pythoncoderV/Bluetooth-Robotic-Arm/(9) TPU Modeling for Grip.md

2/1/25 - 2/12/25; (The last part of the project)

# TPU MODELING FOR TRACTION/GRIP:

I discovered that the three-finger gripper needed more traction to hold circular objects securely after completing the robotic arm structure. The entire bottom
of the arm was slick, so it wasn't just the gripper that lacked traction. On level surfaces, the servo case/enclosure and PVC circular base slid easily, needing
additional grip. I started by using extra rubber sheets I had lying around. The shapes were too asymmetrical and wouldn't fit correctly after being cut to fit the arm.
I was also unable to make the custom elastic support pieces I wanted out of the rubber sheet. TPU filament was the later solution as I would be able to design the custom
parts in CAD, and print them on my Ender 3 3D-printer easily. The printed parts would be very precise, so I started printing. The main challenge was adjusting my Ultimaker 
CURA slicer settings. I had been using normal PLA filament throughout the project, but now with TPU, I needed to change the settings. TPU required higher temperatures and 
better quality settings. After adjusting the TPU, I went to create the CAD models for the parts needed to print. The first parts to design were the TPU pieces for the 
bottom of the robotic arm to keep it in place. I designed two cylinders at a height of 1mm and cut each into halves to get 4 pieces for the PVC circular base. After 
placing them with hot glue, I designed pockets that would wrap around each of the 3 gripper fingers. After designing the pockets, I printed and press-fit them into each finger.

Here is the CAD model for the 2 bottom cylindrical pads (before being cut in halves): 



Here is the CAD model for 1 of the 3-finger gripper pockets: 





This is the final design of the TPU-printed gripper pocket:



These are all 3 of the TPU-printed gripper pockets placed on each of the gripper fingers:



This is a picture of 3 half-cylindrical pads placed on the bottom of the PVC circular base with hot-glue



This is where the 4th half-cylindrical pad was placed due to the edge of the enclosure for the robotic arm touching ground level:
(Refer to Board Management + Enclosure(SERVER).md)
