pythoncoderV/Bluetooth-Robotic-Arm/Custom Created CAD Models (By Me).md

These are the Custom CAD models I created myself for this project (These models are in TinkerCAD's browser website):

Base Construction CAD Model: https://www.tinkercad.com/things/egqu6U74zEA-360-turning-base
___________________________________________________________________________________________________________________________________
Shoulder Construction CAD Model: https://www.tinkercad.com/things/ffeTb6ennbH-arm-shoulder
Shoulder Construction CAD Model for 3D-printing: https://www.tinkercad.com/things/5AqSajbkO6N-arm-shoulder-fr-printing
___________________________________________________________________________________________________________________________________
3-Finger Gripper Construction CAD Model: https://www.tinkercad.com/things/5Qdoo5D9cre-3-finger-robotic-hand

SERVER/Arm Case/Enclosure for boards/parts CAD Model: https://www.tinkercad.com/things/jFY7OoK0D5L-case-fr-serverarm

___________________________________________________________________________________________________________________________________

Modified but taken from Thingiverse (I modified the top cover to add more space inside (Refer to Board Management + Enclosure(CLIENT).md)):

CLIENT/Joystick Remote Case/Enclosure for boards/parts CAD Model: https://www.tinkercad.com/things/i5cvhJYxiae-joystick-remote-caseclient

___________________________________________________________________________________________________________________________________

All TPU created models (3-finger gripper pockets + the 2 bottom cylindrical grip pads): 

https://www.tinkercad.com/things/7bJXujVLc1D-tpu-models-for-grip
