pythoncoderV/Bluetooth-Robotic-Arm/(6) KiCad Wiring Schematic(CLIENT).md

# WIRING(CLIENT):

This is the wiring schematic I used to wire all the components for the client/joystick wireless remote portion of the project. While creating this schematic, 
I realized there was no perfectly accurate KiCad symbol that fit the physical 5 pin 2-axis(x,y) Joystick module on SnapEDA, EasyEDA or anywhere else along the 
reach of the Internet. I then tried to create my own accurate Joystick Symbol for the schematic through the symbol creator/editor accessory:

 

After finishing the symbol, I uploaded it into the full schematic to have complete wiring for the Joystick Remote/client:
(For the ESP32 shown in the schematic, it's using the wrong board but the pins are the exact same as the ESP-WROOM-32 I used for the
project)
