pythoncoderV/Bluetooth-Robotic-Arm/(3) Wrist Joint Construction.md

11/1/25; (The third part of the project)

# WRIST JOINT CONSTRUCTION: 

This part of the project moves the gripper up and down, adding more flexibility to the arm. The wrist joint mounts on top of the shoulder joint's 4-bar linkage slope, creating a third axis of movement so the arm can pick up objects at a wider range. It's powered by a Spektrum A330 servo motor. This design was the most challenging and went through three iterations. I originally wanted to use another MG996R, but it would have been too heavy for the shoulder joint to handle. My first design used revolute joints with a bracket holding two SG90 servos working together to lift the gripper. I used two servos instead of one because the gripper I was building would be heavy. I took pre-made servo cases from Thingiverse.com and fit them into my custom bracket, However, testing showed this didn't work. I had already printed the 3-finger gripper design, so I used it for wrist joint testing. I mounted the bracket with tape on the shoulder joint's end panel for prototyping. The SG90s could carry the gripper's weight at first, but they soon failed. One servo lost its starting position, causing both servos to go out of sync, which caused the synchronized system to fail. I later had to scrap that idea. Design #2 used a completely different motor—the 28BYJ-48 stepper motor because I thought one stronger motor would be more efficient. I then set up the ULN2003 stepper driver module and motor. This design worked well when I taped the stepper motor to the gripper. I used a pre-made case from Thingiverse again for the stepper motor and taped it to the shoulder joint's end panel. The stepper motor was strong and easy to code for moving the gripper. It seemed perfect until I connected all the motors to finish the project. I had already glued the stepper shaft to the gripper, making it hard to go back. When I tested the stepper with all the other servos, it wouldn't move. I think this was due to a power or current shortage. The problem was me initially powering everything through the servo driver board but I couldn't increase the power and current because the board had a limit(PCA9865). I moved to final design #3 needing a motor that could handle the gripper's weight without using too much power. After searching for days, I found a Spektrum A330 motor in my parts collection. I didn't think a servo that size would be powerful enough, but it actually had higher torque than the average SG90 and used less voltage. I taped it to the shoulder joint's end panel and attached the gripper to its shaft so there was no CAD or design needed. It moved the gripper perfectly and met all my requirements, so I hot-glued everything together. After gluing, I had a fully working wrist joint, and the arm's mechanical part was mostly done since I'd already designed the 3-finger gripper.

This is the link to the enclosure of the A330/SG90 servo motor on thingiverse (I only took the servo barrier stl. file): thingiverse.com/thing:2451583/files#google_vignette

I lost the CAD design for design #1's Bracket due to a mistaken refresh on my computer but here is the picture:
WNTW9386 1

This is design #2's stepper motor case link I took from thingiverse as well as the 28BYJ-48 stepper motor + ULN2003 stepper motor driver module picture:

Link: thingiverse.com/thing:5145361



Pictures for the stepper motor design #2 on the robotic arm along with the gripper from later: 
