pythoncoderV/Bluetooth-Robotic-Arm/(1) Base Construction.md

9/1/25; (The first part of the project)

# BASE CONSTRUCTION:

This part of the project was to develop the base of the robotic arm where the wiring components would go and where the base rotation would commence. For this I wanted to use a circular hollow cylindrical piece to house the first base rotation MG996R motor. The diameter for this base was going to be about 100 mm so it wouldn't look too big as well as so it could be able to hold the servo motor conveniently. I did not want to 3D print this piece due to time issues, so I went to Home Depot to later purchase a PVC circular topless piece that was 106 mm in diameter. I then took my first MG996R servo and mounted it to the base of the cylinder along with poles to the edge so when I later put a platform on top of the motor to rotate, it will be supported well. I used hot glue to keep everything in place and mounted rubber frictioners at the base so it won't move around too much. I used a fit-in enclosure for the MG996R by measuring the dimensions and mounted it on the PVC base after 3D-printing.

This is the link for the part: https://www.homedepot.com/p/NDS-PVC-S-D-Cap-4-in-4P06/100172701

Note: Although the link above shows the correct size and shape, I actually purchased the same version but with a railed bottom, not the solid-bottomed one included/pictured. I could not find my version online because I picked it up in person from my local Home Depot.

I then designed a 2 mm tall, 106 mm diameter circular plate that would be mounted onto the servo motor shaft with super glue so I could attach the rest of the arm on top easily:
