pythoncoderV/Bluetooth-Robotic-Arm/(commit log)

2026-02-05 Create Shoulder Joint Construction.md
2026-02-05 Update Shoulder Joint Construction.md
2026-02-05 Update and rename Wrist Construction to Wrist Joint Construction.md
2026-02-05 Update Wrist Joint Construction.md
2026-02-05 Create 3-Finger Gripper Construction
2026-02-06 Create KiCAD Wiring Schematic(SERVER).md
2026-02-06 Create KiCAD Wiring Schematic(Client).md
2026-02-06 Update and rename KiCAD Wiring Schematic(Client).md to KiCAD Wiring Schematic(CLIENT).md
2026-02-06 Update KiCAD Wiring Schematic(SERVER).md
2026-02-06 Update and rename 3-Finger Gripper Construction to 3-Finger Gripper Construction.md
2026-02-06 Update 3-Finger Gripper Construction.md
2026-02-08 Create Wiring + Board Management.md
2026-02-08 Update and rename Wiring + Board Management.md to Board Management + Enclosures.md
2026-02-08 Update Board Management + Enclosures.md
2026-02-08 Update and rename Board Management + Enclosures.md to Board Management + Enclosure(SERVER).md
2026-02-08 Create Board Management + Enclosure(CLIENT).md
2026-02-08 Update Board Management + Enclosure(CLIENT).md
2026-02-08 Update Board Management + Enclosure(SERVER).md
2026-02-08 Create Power Management(CLIENT+SERVER).md
2026-02-08 Update Power Management(CLIENT+SERVER).md
2026-02-08 Rename KiCAD Wiring Schematic(SERVER).md to KiCad Wiring Schematic(SERVER).md
2026-02-08 Rename KiCAD Wiring Schematic(CLIENT).md to KiCad Wiring Schematic(CLIENT).md
2026-02-08 Update KiCad Wiring Schematic(CLIENT).md
2026-02-09 Create CODE (SERVER ESP32-DEVKITC-32U)
2026-02-09 Update CODE (SERVER ESP32-DEVKITC-32U)
2026-02-09 Create CODE (CLIENT ESP32-DEVKITC-32U)
2026-02-09 Update CODE (CLIENT ESP32-DEVKITC-32U)
2026-02-12 Update and rename CODE (SERVER ESP32-DEVKITC-32U) to CODE (SERVER ESP-WROOM-32)
2026-02-12 Update and rename CODE (CLIENT ESP32-DEVKITC-32U) to CODE (CLIENT ESP-WROOM-32)
2026-02-12 Update and rename B.O.M. (Bill Of Materials) - Sheet1.csv to B.O.M. (Bill Of Materials) - Sheet.csv
    [B.O.M. (Bill Of Materials) - Sheet.csv]
2026-02-12 Update B.O.M. (Bill Of Materials) - Sheet.csv
    [B.O.M. (Bill Of Materials) - Sheet.csv]
2026-02-12 Create Custom Created CAD Models(By Me).md
2026-02-12 Update Custom Created CAD Models(By Me).md
2026-02-18 Update and rename B.O.M. (Bill Of Materials) - Sheet1 (1).csv to B.O.M. (Bill Of Materials) - Sheet.csv
    [B.O.M. (Bill Of Materials) - Sheet.csv]
2026-02-21 Rename Shoulder Joint Construction.md to (2) Shoulder Joint Construction.md
2026-02-21 Rename Wrist Joint Construction.md to (3) Wrist Joint Construction.md
2026-02-21 Rename 3-Finger Gripper Construction.md to (4) 3-Finger Gripper Construction.md
2026-02-21 Rename Board Management + Enclosure(CLIENT).md to (5) Board Management + Enclosure(CLIENT).md
2026-02-21 Rename (5) Board Management + Enclosure(CLIENT).md to Board Management + Enclosure(CLIENT).md
2026-02-21 Rename KiCad Wiring Schematic(CLIENT).md to (5) KiCad Wiring Schematic(CLIENT).md
2026-02-21 Rename (5) KiCad Wiring Schematic(CLIENT).md to (6) KiCad Wiring Schematic(CLIENT).md
2026-02-21 Rename KiCad Wiring Schematic(SERVER).md to (5) KiCad Wiring Schematic(SERVER).md
2026-02-21 Rename Board Management + Enclosure(CLIENT).md to (7) Board Management + Enclosure(CLIENT).md
2026-02-21 Rename Board Management + Enclosure(SERVER).md to (8) Board Management + Enclosure(SERVER).md
2026-03-05 Update (2) Shoulder Joint Construction.md
2026-03-05 Update (3) Wrist Joint Construction.md
2026-03-05 Update (4) 3-Finger Gripper Construction.md
2026-03-05 Update (5) KiCad Wiring Schematic(SERVER).md
2026-03-05 Update (6) KiCad Wiring Schematic(CLIENT).md
2026-03-05 Update (7) Board Management + Enclosure(CLIENT).md
2026-03-05 Update (8) Board Management + Enclosure(SERVER).md
2026-03-19 Rename Custom Created CAD Models(By Me).md to Custom Created CAD Models (By Me).md
2026-03-19 Rename Custom Created CAD Models (By Me).md to Custom Created CAD Models (By Me)
2026-03-19 Rename Custom Created CAD Models (By Me) to Custom Created CAD Models (By Me).md
